aeremin/chibi-armlet/README.md

View this project on [CADLAB.io](https://cadlab.io/project/1101). 

Fallout Device project.

-- Moved from https://code.google.com/p/chibi-armlet
