aeremin/chibi-armlet/Hardware/Gerber/Berelcom/Бланк заказа печатных плат.xls

 | ООО “Берёзка Электронные Компоненты”
 | www.berelcom.ru e-mail: project@berelcom.ru тел./факс (495) 781-59-25
 | г. Москва, Колодезный переулок, д.3, стр.23, офис № 11
Бланк заказа печатных плат |  |  |  | Наличный |  | Необходим |  | Новый
Данные о заказчике |  |  |  | Безналичный |  | Не нужен |  | Повторный (без изменений)
Название фирмы или имя заказчика |  | ООО «ВВПАСС Корпорация»
ИНН |  | 7728668847
КПП |  | 770501001 |  | Зеленая | Мультипликации нет - каждая плата отдельно | Отсутствует |  | ОПП - односторонняя
Плательщик (если различно с заказчиком) |  |  |  | Бесцветная | Мультипликация есть - описано в дополнених | Жидкая |  | ДПП - двухсторонняя
Адрес (юридический), включая индекс |  | 115184, г. Москва, ул. Большая Татарская, д. 42 |  | Синяя |  | Жидкая Imagecure |  | МПП - многослойная
Телефон/факс с указанием кода города |  | +7 916 989 5800 |  | Желтая |  | Пленочная
e-mail |  | laystoll@yandex.ru |  | Чёрная |  | Сухая
Контактное лицо по заказу |  | Геннадий Круглов |  | Красная |  | Сухая DYNAMASK
Вид расчёта |  | Безналичный |  |  |  | Фотомаска жидкая
Параметры заказываемых плат |  |  |  |  |  | Фотоэкспонируемая термоотверждаемая
Название платы (должно совпадать с названием файла) |  | Chibiarmlet3
Новый или повторный (без изменений) заказ в ООО "Березка ЭК" |  | Новый |  |  |  |  | FR4 | Горячее лужение (HAL)
Система проектирования |  | GERBER |  | Не закрыты маской |  |  | FR2 | Бессвинцовое горячее лужение (HASL)
Количество слоев |  | ДПП - двухсторонняя | Количество слоев для МПП | Закрыты маской |  |  | FR1 | хим. Ni/Au
Количество, шт. |  | 700 |  |  |  |  | CEM-1 | гальв. Ni/Au
Длина платы, мм. (максимальное значение 1100 мм) |  | 114 |  | Скрайбирование |  |  | CEM-1 | Карбоновое покрытие (Carbon)
Ширина платы, мм. (максимальное значение 610 мм) |  | 16 |  | Фрезеровка
Толщина платы, мм. (стандартное значение 1,6 мм) |  | 1.5 |  | Вырубка |  | 0.8 | 5
Тип материала (стандартное значение: FR4) |  | FR4 |  |  |  | 1 | 9
Срок производства (стандартное значение: 4 недели) |  | 4 недели |  | 1 неделя |  | 1.2 | 17.5
Толщина медной фольги (стандартное значение: 35мкм) |  | 35 |  | 2 недели |  | 1.5 | 35
Наличие и тип маски (стандартное значение: жидкая) |  | Жидкая |  | 4 недели |  | 1.55 | 70
Цвет паяльной маски (стандартное значение: зеленая) |  | Зеленая |  |  |  | 1.6 | 105
Наличие шелкографии |  | Только на стороне TOP |  | Отсутствует |  | 2 | Иное - описано в дополнениях
Переходные отверстия (стандартное значение: не закрыты маской) |  | Не закрыты маской |  | С двух сторон |  | 2.4
Мехобработка контура |  | Фрезеровка |  | Только на стороне TOP |  | 3.2
Необходимость мультиплицирования плат на заготовке |  | Мультипликация есть - описано в дополнених |  | Только на стороне BOTTOM |  | Иное - описано в дополнениях
Электротест |  | Необходим
Покрытие контактных площадок (стандартное значение: HASL) |  | Бессвинцовое горячее лужение (HASL)
Дополнительные требования
Нужна сборка плат: трафарет, закупка и монтаж компонентов
При подготовке трафарета просьба связаться с нами: нужно не наносить пасту на контактные площадки немонтируемых компонентов
