aeremin/chibi-armlet/Hardware/Gerber/Berelcom/ChibiArmlet-BOM.xlsx

Document version | ChibiArmlet-BOM v.20131229.1300
Reference | Footprint | Value | Item count | Price | URL | Комментарий
Микросхемы
DD1 | LQFP-48 | STM32L151CBT | 1 | $2.62 | http://www.compel.ru/infosheet/ST/STM32L151CBT6/
DD2 | QFN20 | CC1101 | 1 | $1.86 | http://www.compel.ru/infosheet/TI/CC1101RTKR/
DA1 | SOT23-5 | NCP1400ASN33 | 1 | $0.4044 | http://www.compel.ru/infosheet/ONS/NCP1400ASN33T1G/ | Источник питания
Активные компоненты
Q1, Q2 | SOT23 | MMBT2222 | 2 | $0.0101 | http://www.compel.ru/infosheet/NXP/MMBT2222A.215/
Q3 | LED5050 | LED_RGB | 1 | 1.86р | http://www.zip-2002.ru/?z=grey&i=119&p=651&id=96169/
D1, D2 | SOD-323 | BAT54WS | 2 | $0.023 | http://www.berelcom.ru/shop/show_good.php?idtov=2130747219&grid= | Диод Шоттки
Пассивные компоненты
XTAL1 | SMD3225 | 27MHz | 1 | 7.65р | http://www.quartz1.com/price/model.php?akt=6935.12 | Резонатор на 27МГц 10ppm в SMD корпусе размером 3.2х2.5мм
BZ1 | DIP2 | HC0903A | 1 | 7.5р | http://www.quartz1.com/price/model.php?akt=8420.12 | Пищалка
Конденсаторы
C1, C12, C17, C22, C24 | CAP_0603 | 10u 6.3V | 5 | $0.084 | http://www.compel.ru/infosheet/MUR/GRM188R60J106ME47D/ | Конденсатор в корпусе 0603, точность 20%, напряжение не менее 6.3В
C2 | CAP_0402 | 1.8pF | 1 | $0.045 | http://www.digikey.com/product-detail/en/500R07S1R8BV4T/712-1271-1-ND/1786733 | Конденсатор JOHANSON p/n 500R07S1R8BV4T
C3, C8 | CAP_0402 | 220pF | 2 |  |  | Конденсатор в корпусе 0402, диэлектрик NPO, точность 5%
C4, C6, C15 | CAP_0402 | 10n | 3 |  |  | Конденсатор в корпусе 0402, точность 20%
C5 | CAP_0402 | 3.3pF | 1 |  |  | Конденсатор в корпусе 0402, диэлектрик NPO, точность 5%
C7, C11, C13, C14, C18, C21, C23 | CAP_0402 | 0.1u | 7 |  |  | Конденсатор в корпусе 0402, точность 20%
C9, C10 | CAP_0402 | 10pF | 2 |  |  | Конденсатор в корпусе 0402, диэлектрик NPO, точность 5%
С16 | CAP_0402 | 1u | 1 |  |  | Конденсатор в корпусе 0402, точность 20%
Резисторы
R1, R4, R12 | RES_0402 | 1k | 3 |  |  | Резистор в корпусе 0402, точность не хуже 5%
R2 | RES_0402 | 56k | 1 |  |  | Резистор в корпусе 0402, точность не хуже 1%
R5, R6 | RES_0402 | 4k7 | 2 |  |  | Резистор в корпусе 0402, точность не хуже 5%
R7 | RES_0402 | 150R | 1 |  |  | Резистор в корпусе 0402, точность не хуже 5%
R8, R9, R10 | RES_0402 | 51R | 3 |  |  | Резистор в корпусе 0402, точность не хуже 5%
Индуктивности
L1 | IND_0402 | 5.6nH | 1 | $0.02926 | http://www.digikey.com/product-detail/en/L-07C5N6SV6T/712-1462-1-ND/1915241 | Катушка JOHANSON p/n L-07C5N6SV6T
L2 | IND_1210 | 22uH | 1 | $0.14576 | http://www.digikey.com/product-detail/en/CBC3225T220MR/587-1626-1-ND/1008241 | Индуктивность 22uH +- 20%, ток рабочий и насыщения не менее 500мА, сопротивление не более 0.5Ом
BLN1 | BLN_0805 | 0896BM15A0001E | 1 | $0.5225 | http://www.compel.ru/infosheet/JOHANSON/0896BM15A0001E/
Разъемы
XL1, XL2, XL3 |  | Do not mount | 0
XL4 | DIP4 | PBS-1x04R | 1 | 1.29р | http://www.zip-2002.ru/?z=grey&i=97&p=332&id=58364/ | Разъем 1х4 угловой, шаг 2.54мм
B3 | Держатель 1хAA | BH311 | 1 | 4.11р | http://www.zip-2002.ru/?z=grey&i=109&p=401&id=59649/ | Держатель одной батарейки АА с монтажом на плату.
M1 |  | Do not mount | 0
