aeremin/chibi-armlet/Hardware/Gerber/Berelcom/BOM_Request.xlsx

Название | Тип | Корпус | Ссылка | Цена по ссылке | Требуемые характеристики
Контроллер | STM32F030C8T6 | LQFP-48 | http://riv-e.ru/price/STM32F030C8T6 | 35.1р
Контроллер | STM32F051C8T6 | LQFP-48 | http://www.compel.ru/infosheet/ST/STM32F051C8T6/ | $1.5
Контроллер | STM32L151C8T6 | LQFP-48 | http://www.compel.ru/infosheet/ST/STM32L151C8T6/ | $2.69
Контроллер | STM32L151CBT6 | LQFP-48 | http://www.compel.ru/infosheet/ST/STM32L151CBT6/ | $2.62
Радиотрансивер |  | QFN-20 | http://www.compel.ru/infosheet/TI/CC1101RTKR/ | $1.86
Источник питания | NCP1400ASN33 | SOT23-5 | http://www.compel.ru/infosheet/ONS/NCP1400ASN33T1G/ | $0.4044
Диод Шоттки | MBR0520LT1G | SOD-123 | http://www.compel.ru/infosheet/ONS/MBR0520LT1G/ | $0.0592
Транзистор NPN | MMBT2222 | SOT23 | http://www.compel.ru/infosheet/NXP/MMBT2222A.215/ | $0.0101
RGB светодиод |  | SMD 5050 | http://www.zip-2002.ru/?z=grey&i=119&p=651&id=96169/ | 1.86р
Кварц. резонатор |  | SMD 3225 | http://www.quartz1.com/price/model.php?akt=6935.12 | 7.65р | Резонатор на 27МГц 10ppm в SMD корпусе размером 3.2х2.5мм или меньше.
BALUN | 0896BM15A0001E | 0805 | http://www.compel.ru/infosheet/JOHANSON/0896BM15A0001E/ | $0.5225
Пищалка | HC0903A |  | http://www.quartz1.com/price/model.php?akt=8420.12 | 7.5р
Конденсаторы
1.8pF | 500R07S1R8BV4T | 0402 | http://www.digikey.com/product-detail/en/500R07S1R8BV4T/712-1271-1-ND/1786733 | $0.045 | Конденсатор JOHANSON p/n 500R07S1R8BV4T
3.3pF |  | 0402 |  |  | Конденсатор в корпусе 0402, диэлектрик NPO, точность 5%
10pF |  | 0402 |  |  | Конденсатор в корпусе 0402, диэлектрик NPO, точность 5%
100pF |  | 0402 |  |  | Конденсатор в корпусе 0402, диэлектрик NPO, точность 5%
220pF |  | 0402 |  |  | Конденсатор в корпусе 0402, диэлектрик NPO, точность 5%
10n |  | 0402 |  |  | Конденсатор в корпусе 0402, точность 20%
0.1u |  | 0402 |  |  | Конденсатор в корпусе 0402, точность 20%
1u |  | 0402 |  |  | Конденсатор в корпусе 0402, точность 20%
10u |  | 0603 | http://www.compel.ru/infosheet/MUR/GRM188R60J106ME47D/ | $0.084 | Конденсатор в корпусе 0603, точность 20%, напряжение не менее 6.3В
Резисторы
51R |  | 0402 |  |  | Резистор в корпусе 0402, точность не хуже 5%
150R |  | 0402 |  |  | Резистор в корпусе 0402, точность не хуже 5%
1k |  | 0402 |  |  | Резистор в корпусе 0402, точность не хуже 5%
4k7 |  | 0402 |  |  | Резистор в корпусе 0402, точность не хуже 5%
56k |  | 0402 |  |  | Резистор в корпусе 0402, точность не хуже 1%
Индуктивности
5.6nH | L-07C5N6SV6T | 0402 | http://www.digikey.com/product-detail/en/L-07C5N6SV6T/712-1462-1-ND/1915241 | $0.02926 | Катушка JOHANSON p/n L-07C5N6SV6T
22uH | CBC3225T220MR | 1210 | http://www.digikey.com/product-detail/en/CBC3225T220MR/587-1626-1-ND/1008241 | $0.14576 | Индуктивность 22uH +- 20%, ток рабочий и насыщения не менее 500мА, сопротивление не более 0.5Ом, размер не более 1210.
Разъемы и прочее
PBS | PBS2-04R |  | http://www.zip-2002.ru/?z=grey&i=97&p=441&id=63418/ | 2.53р
Держатель 1хAA | BH311 |  | http://www.zip-2002.ru/?z=grey&i=109&p=401&id=59649/ | 4.11р | Держатель одной батарейки АА с монтажом на плату.
