aeremin/chibi-armlet/Hardware/Gerber/Rezonit/ChibiArmlet-BOM.xlsx

Document version | ChibiArmlet-BOM v.20131105.2258
Reference | Footprint | Value | Item count | Description | Solder Point per cmp | SolderPoint total
Микросхемы
DD1 | UFQFPN48 | STM32L100C6 | 1 | Предоставим в трее | 49 | 49
DD2 | QFN20 | CC1101 | 1 | Предоставим в трее | 20 | 20
DA1 | SOT23-5 | NCP1400ASN33 | 1 | Предоставим в ленте | 5 | 5
Активные компоненты
Q1 | SOT23 | MMBT2222 | 1 | Предоставим в ленте | 3 | 3
Q3 | LED5050 | LED_RGB | 1 | Предоставим в ленте | 6 | 6
D1 | SOD-323 | BAT54WS | 1 | Предоставим в ленте | 2 | 2
Пассивные компоненты
XTAL1 | SMD3225 | 27MHz | 1 | Предоставим в ленте | 4 | 4
BZ1 | DIP2 | Do not mount
Конденсаторы
C1 | CAP_0402 | 100pF NPO | 1 | Предоставим в ленте | 2 | 2
C2 | CAP_0402 | 1.8pF NPO | 1 | Предоставим в ленте | 2 | 2
C3, C8 | CAP_0402 | 220pF NPO | 2 | Предоставим в ленте | 2 | 4
C4, C6, C15 | CAP_0402 | 10nF | 3 | Предоставим в ленте | 2 | 6
C5 | CAP_0402 | 3.3pF NPO | 1 | Предоставим в ленте | 2 | 2
C7, C11, C13, C14, C21, C23 | CAP_0402 | 0.1u | 6 | Предоставим в ленте | 2 | 12
C9, C10 | CAP_0402 | 10pF | 2 | Предоставим в ленте | 2 | 4
C12, C22, C24 | CAP_0805 | 10uF | 3 | Предоставим в ленте | 2 | 6
С16 | CAP_0402 | 1uF | 1 | Предоставим в ленте | 2 | 2
Резисторы
R1, R4 | RES_0402 | 1k | 2 | Предоставим в ленте | 2 | 4
R2 | RES_0402 | 56k | 1 | Предоставим в ленте | 2 | 2
R3 | RES_0402 | Do not mount
R5, R6 | RES_0402 | 4k7 | 2 | Предоставим в ленте | 2 | 4
R7 | RES_0603 | 150R | 1 | Предоставим в ленте | 2 | 2
R8, R9, R10 | RES_0402 | 51R | 3 | Предоставим в ленте | 2 | 6
Индуктивности
L1 | IND_0402 | 5.6nH | 1 | Предоставим в ленте | 2 | 2
L2 | IND_1210 | 22uH | 1 | Предоставим в ленте | 2 | 2
BLN1 | BLN_0805 | 0896BM15A0001E | 1 | Предоставим в ленте | 6 | 6
Разъемы
XL1, XL2, XL3 |  | Do not mount
XL4 | DIP4@2mm | Do not mount
BH3 | DIP2 | Do not mount |  |  | Solder points per brd | 88
