aeremin/chibi-armlet/ChangeLog.docx

V1 – V2

- Корпус проца LQFP вместо QFN.
- Диод в корпусе SOD123 вместо SOD323
- Конденсаторы 10мкФ в корпусе 0603 вместо 0805
- Резистор 150 Ом в корпусе 0402 вместо 0603
- Две REFPOINTS, а не четыре
- Добавить Debug conn
- Добавить вибромотор
