aeremin/chibi-armlet/Hardware/ChibiArmletPcb.pdf

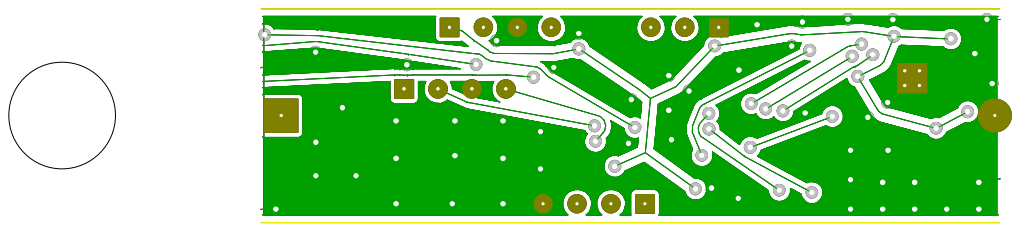
[picture p1: page 1]
