aeremin/chibi-armlet/Pill/Pill4.kicad_pcb

## KiCad design Pill/Pill4.kicad_pcb (2014-04-10)

Schematic: Pill4.sch

Parts:
C1: 0.1u; CAP_0603
DD1: M24C04; SO8E
F1, F2, F3: FUSE0R
XL1: CONN_4

Connections:
+3.3V: C1.1, DD1.8 (Vcc), F1.2, F2.2, F3.2, XL1.1
/1: DD1.1 (A0), F1.1
/2: DD1.2 (A1), F2.1
/3: DD1.3 (A2), F3.1
/I2C_SCL: DD1.6 (SCL), XL1.2 (PM)
/I2C_SDA: DD1.5 (SDA), XL1.4
GND: C1.2, DD1.4 (GND), DD1.7 (WP), XL1.3

Notes on the sheet:
I2C Addr = 1010 (A2)(A1)(A0) in case of 1 or 2 kBit, I2C Addr = 1010 (A2)(A1) in case of 4 kBit. A2, A1, A0 are read as 0 when left floating

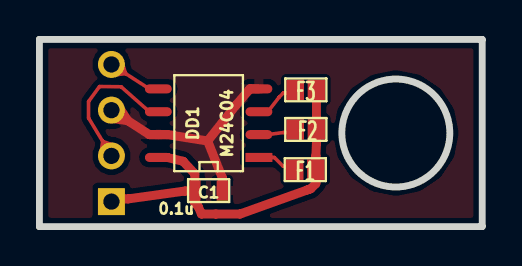
[picture p2: board Pill4.kicad_pcb from above]

Board: 2 copper layers, 24.6 x 10.4 mm, 6 parts (1 on the bottom side), 7 nets.
