aeremin/chibi-armlet/Hardware/ChibiArmlet.kicad_pcb

## KiCad design Hardware/ChibiArmlet.kicad_pcb (2013-12-29)

Schematic: ChibiArmlet.sch

Parts:
ANT1: ANT_PCB_MONO
B3: BAT
BLN1: 0896BM15A0001
BZ1: BUZZER
C1, C12, C17: 10u; CAP_0603
C2: 1.8pF
C3, C8: 220pF
C4, C6: 10n
C5: 3.3pF
C7, C11, C21, C23: 0.1u
C9, C10: 10pF; CAP_0402
C13, C14, C18: 0.1u; CAP_0402
C15: 10n; CAP_0402
C16: 1u; CAP_0402
C22, C24: 10u
D1, D2: BAT54WS
DA1: NCP1400
DD1: STM32L151CXTX
DD2: CC1101
L1: 5.6nH; IND_0402
L2: 22uH
M1: MOTOR_PAD
Q1, Q2: MMBT2222
Q3: LED_RGB 5050
R1: 1k; RES_0402
R2: 56k
R4, R12: 1k
R5, R6: 4K7; RES_0402
R7: 150; RES_0402
R8, R9, R10: 51R; RES_0603
RP1, RP2: REFPOINT
TP1, TP2: TESTPOINT
XL1: ST_SWD
XL2: CONN_3
XL3: CONN_4
XL4: CONN_4
XTAL1: 27MHz; 03225

Connections:
+3.3V: BZ1.1, C3.1, C4.1, C5.1, C6.1, C7.1, C8.1, C12.1, C13.1, C14.1, C15.1, C16.1, C17.1, C18.1, C23.1, C24.1, D2.C, DA1.1 (CE), DA1.2 (OUT), DD1.1, DD1.9, DD1.24, DD1.36, DD1.48, DD2.4 (DVDD), DD2.9 (AVDD), DD2.11 (AVDD), DD2.14 (AVDD), DD2.15 (AVDD), DD2.18 (DGUARD), XL1.1 (Vdd)
+BATT: B3.A, C1.1, C21.1, C22.1, D1.C, L2.2, M1.2 (-), R1.2
/BLUE_LED: DD1.18, R10.1
/Buzzer: DD1.39, R4.1
/BuzzerOut: BZ1.2, Q2.3 (C)
/CC_CS: DD1.14, DD2.7 (CSn)
/CC_GDO0: DD1.13, DD2.6 (GDO0), TP1.1
/CC_GDO2: DD1.12, DD2.3 (GDO2), TP2.1
/CC_MISO: DD1.16, DD2.2 (SO(GDO1))
/CC_MOSI: DD1.17, DD2.20 (SI)
/CC_SCK: DD1.15, DD2.1 (SCLK)
/GREEN_LED: DD1.41, R9.1
/Lout: D2.A, DA1.5 (LX), L2.1
/P_SCL: DD1.45, R5.1, XL4.2 (PM)
/P_SDA: DD1.46, R6.1, XL4.4
/PeriphPwr: DD1.43, R5.2, R6.2, R7.2
/PeriphPwr1: R7.1, XL4.1
/RED_LED: DD1.19, R8.1
/RF1: BLN1.4 (Bal2), DD2.12 (RF_P)
/RF2: BLN1.3 (Bal1), DD2.13 (RF_N)
/SWCLK: DD1.37, XL1.2 (SWCLK)
/SWDIO: DD1.34, XL1.4 (SWDIO)
/UART_RX: DD1.31, XL2.3
/UART_TX: DD1.30, XL2.2 (PM)
/Vibro: DD1.42, R12.1
/VibroOut: D1.A, M1.1 (+), Q1.3 (C)
GND: B3.C, BLN1.2 (GND), BLN1.5 (GND), BLN1.6 (GND), C1.2, C2.2, C3.2, C4.2, C5.2, C6.2, C7.2, C8.2, C9.2, C10.2, C11.2, C12.2, C13.2, C14.2, C15.2, C16.2, C17.2, C18.2, C21.2, C22.2, C23.2, C24.2, DA1.4 (GND), DD1.8, DD1.23, DD1.35, DD1.44, DD1.47, DD2.16 (GND), DD2.19 (GND), DD2.PAD (GND), M1.PAD (GND), Q1.2 (E), Q2.2 (E), Q3.BC (B), Q3.GC (G), Q3.RC, R2.2, XL1.3 (GND), XL2.1, XL3.4, XL4.3, XTAL1.H
unnamed: BLN1.1 (Unbal), L1.2
unnamed: Q3.BA, R10.2
unnamed: Q3.RA, R8.2
unnamed: Q3.GA, R9.2
unnamed: Q2.1 (B), R4.2
unnamed: C11.1, DD2.5 (DCOUPL)
unnamed: C10.1, DD2.10 (XOSC_Q2), XTAL1.2
unnamed: C9.1, DD2.8 (XOSC_Q1), XTAL1.1
unnamed: DD2.17 (RBIAS), R2.1
unnamed: DD1.10, R1.1
unnamed: ANT1.1, C2.1, L1.1
unnamed: Q1.1 (B), R12.2
unnamed: DD1.4, XL3.1
unnamed: DD1.3, XL3.2 (PM)
unnamed: DD1.2, XL3.3

Notes on the sheet:
Debug port
Programming
CPU
Indication
Power
Radio
Matching circuit
L-07C5N6SV4
500R07S1R8BV4
Peripheral I2C Pull-Ups
Pill Connector
Pill
1xAA
Just Pins

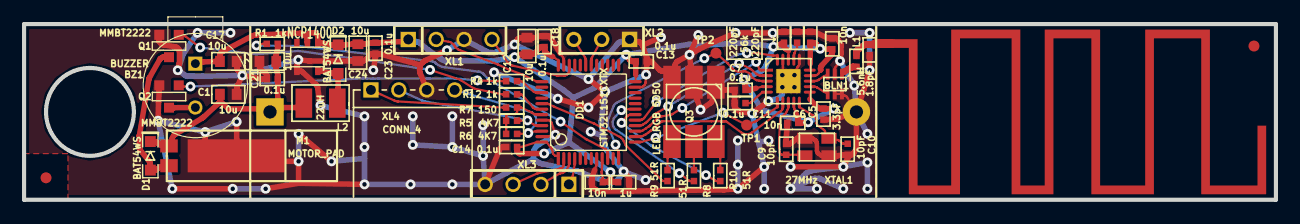
[picture p3: board ChibiArmlet.kicad_pcb from above]

Board: 2 copper layers, 114.0 x 16.0 mm, 56 parts (0 on the bottom side), 42 nets.
