aeremin/chibi-armlet/Firmware/Basic/src/main.cpp

/*
 * File:   main.cpp
 * Author: Kreyl
 * Project: Armlet2South
 *
 * Created on Feb 05, 2013, 20:27
 */

#include <main.h>
#include "kl_lib.h"
#include "ch.h"
#include "hal.h"
#include "clocking_L1xx.h"
#include "uart.h"
#include "radio_lvl1.h"
#include "evt_mask.h"
#include "vibro.h"
#include "Sequences.h"

Vibro_t Vibro(GPIOB, 6, TIM4, 1);
App_t App;

#if 1 // ============================ Timers ===================================
void TmrSecondCallback(void *p) {
    chSysLockFromIsr();
    App.SignalEvtI(EVTMSK_EVERY_SECOND);
    chVTSetI(&App.TmrSecond, MS2ST(1000), TmrSecondCallback, nullptr);
    chSysUnlockFromIsr();
}
#endif

int main(void) {
    // ==== Init Vcore & clock system ====
    SetupVCore(vcore1V2);
    Clk.UpdateFreqValues();
    // ==== Init OS ====
    halInit();
    chSysInit();
    // ==== Init Hard & Soft ====
    App.InitThread();
    chVTSet(&App.TmrSecond, MS2ST(1000), TmrSecondCallback, nullptr);
    Uart.Init(115200);
    Uart.Printf("\r%S  AHB freq=%u", VERSION_STRING, Clk.AHBFreqHz);
//    Led.Init();

//    Radio.Init();

    Vibro.Init();


    // Main cycle
    App.ITask();
}


__attribute__ ((__noreturn__))
void App_t::ITask() {
    while(true) {
        Vibro.StartSequence(vsqBrrBrr);
        chThdSleepMilliseconds(1800);
//        chThdSleepMilliseconds(999);
//        uint32_t EvtMsk = chEvtWaitAny(ALL_EVENTS);
        // ==== Uart cmd ====
//        if(EvtMsk & EVTMSK_UART_NEW_CMD) {
//            OnUartCmd(&Uart);
//            Uart.SignalCmdProcessed();
//        }

        // ==== Every second ====
//        if(EvtMsk & EVTMSK_EVERY_SECOND) {
            // Get mode
//            uint8_t b = GetDipSwitch();
//            b &= 0b00000111;    // Consider only lower bits
//            Mode_t NewMode = static_cast<Mode_t>(b);
//            if(Mode != NewMode) {
//                if(Mode == mError) Led.StartSequence(lsqFailure);
//                else {
//                    Led.StartSequence(lsqStart);
//                    Mode = NewMode;
//                }
//                chThdSleepMilliseconds(540);
//            }
//        }

#if 0 // ==== Radio ====
        if(EvtMsk & EVTMSK_RADIO_RX) {
            Uart.Printf("\rRadioRx");
            chVTRestart(&ITmrRadioTimeout, S2ST(RADIO_NOPKT_TIMEOUT_S), EVTMSK_RADIO_ON_TIMEOUT);
            if(Mode == mRxLight or Mode == mRxVibroLight)
        }
        if(EvtMsk & EVTMSK_RADIO_ON_TIMEOUT) {
//            Uart.Printf("\rRadioTimeout");
            RadioIsOn = false;
            Interface.ShowRadio();
            IProcessLedLogic();
        }
#endif

#if 0 // ==== Saving settings ====
        if(EvtMsk & EVTMSK_SAVE) { ISaveSettingsReally(); }
#endif

    } // while true
}

void App_t::OnUartCmd(Uart_t *PUart) {
    UartCmd_t *PCmd = &PUart->Cmd;
    __attribute__((unused)) int32_t dw32 = 0;  // May be unused in some configurations
    Uart.Printf("\r%S\r", PCmd->Name);
    // Handle command
    if(PCmd->NameIs("Ping")) PUart->Ack(OK);

//    else if(PCmd->NameIs("GetID")) Uart.Reply("ID", ID);

//    else if(PCmd->NameIs("SetID")) {
//        if(PCmd->GetNextToken() != OK) { PUart->Ack(CMD_ERROR); return; }
//        if(PCmd->TryConvertTokenToNumber(&dw32) != OK) { PUart->Ack(CMD_ERROR); return; }
//        uint8_t r = ISetID(dw32);
//        PUart->Ack(r);
//    }

    else PUart->Ack(CMD_UNKNOWN);
}
