aeremin/chibi-armlet/Firmware/Common/kl_lib/kl_lib_L15x.h

/*
 * kl_lib_f0xx.h
 *
 *  Created on: 10.12.2012
 *      Author: kreyl
 */

#ifndef KL_LIB_F100_H_
#define KL_LIB_F100_H_

#include "stm32l1xx.h"
#include "ch.h"
#include "hal.h"
#include "clocking_L1xx.h"
#include "core_cmInstr.h"
#include <cstdlib>

#if 1 // ============================ General ==================================
#define PACKED __attribute__ ((__packed__))
#ifndef countof
#define countof(A)  (sizeof(A)/sizeof(A[0]))
#endif

// Constants
#ifndef TRUE
#define TRUE 1
#endif
#ifndef FALSE
#define FALSE 0
#endif
#define MAX_INT32       0x7FFFFFFF
#define MIN_INT32       (-2147483647)
#define MAX_UINT32      0xFFFFFFFF

// Return values
#define OK              0
#define FAILURE         1
#define TIMEOUT         2
#define BUSY            3
#define NEW             4
#define IN_PROGRESS     5
#define LAST            6
#define CMD_ERROR       7
#define WRITE_PROTECT   8
#define CMD_UNKNOWN     9
#define EMPTY_STRING    10
#define NOT_A_NUMBER    11

// Binary semaphores
#define NOT_TAKEN       false
#define TAKEN           true

enum BitOrder_t {boMSB, boLSB};
enum LowHigh_t  {Low, High};
enum RiseFall_t {Rising, Falling};

typedef void (*ftVoidVoid)(void);

// Simple pseudofunctions
// Simple pseudofunctions
#define MIN(a, b)   ( ((a)<(b))? (a) : (b) )
#define MAX(a, b)   ( ((a)>(b))? (a) : (b) )
#define TRIM_VALUE(v, Max)  { if((v) > (Max)) (v) = (Max); }
#define IS_LIKE(v, precise, deviation)  (((precise - deviation) < v) and (v < (precise + deviation)))

#define ANY_OF_2(a, b1, b2)             (((a)==(b1)) or ((a)==(b2)))
#define ANY_OF_3(a, b1, b2, b3)         (((a)==(b1)) or ((a)==(b2)) or ((a)==(b3)))
#define ANY_OF_4(a, b1, b2, b3, b4)     (((a)==(b1)) or ((a)==(b2)) or ((a)==(b3)) or ((a)==(b4)))
#define ANY_OF_5(a, b1, b2, b3, b4, b5) (((a)==(b1)) or ((a)==(b2)) or ((a)==(b3)) or ((a)==(b4)) or ((a)==(b5)))

// IRQ priorities
#define IRQ_PRIO_LOW            15  // Minimum
#define IRQ_PRIO_MEDIUM         9
#define IRQ_PRIO_HIGH           7
#define IRQ_PRIO_VERYHIGH       4   // Higher than systick

// DMA
#define DMA_PRIORITY_LOW        STM32_DMA_CR_PL(0b00)
#define DMA_PRIORITY_MEDIUM     STM32_DMA_CR_PL(0b01)
#define DMA_PRIORITY_HIGH       STM32_DMA_CR_PL(0b10)
#define DMA_PRIORITY_VERYHIGH   STM32_DMA_CR_PL(0b11)

// Different conversions
class Convert {
public:
    static void U16ToArrAsBE(uint8_t *PArr, uint16_t N) {
        uint8_t *p8 = (uint8_t*)&N;
        *PArr++ = *(p8 + 1);
        *PArr   = *p8;
    }
    static void U32ToArrAsBE(uint8_t *PArr, uint32_t N) {
        uint8_t *p8 = (uint8_t*)&N;
        *PArr++ = *(p8 + 3);
        *PArr++ = *(p8 + 2);
        *PArr++ = *(p8 + 1);
        *PArr   = *p8;
    }
    static uint16_t ArrToU16AsBE(uint8_t *PArr) {
        uint16_t N;
        uint8_t *p8 = (uint8_t*)&N;
        *p8++ = *(PArr + 1);
        *p8 = *PArr;
        return N;
    }
    static uint32_t ArrToU32AsBE(uint8_t *PArr) {
        uint32_t N;
        uint8_t *p8 = (uint8_t*)&N;
        *p8++ = *(PArr + 3);
        *p8++ = *(PArr + 2);
        *p8++ = *(PArr + 1);
        *p8 = *PArr;
        return N;
    }
    static void U16ChangeEndianness(uint16_t *p) { *p = __REV16(*p); }
    static void U32ChangeEndianness(uint32_t *p) { *p = __REV(*p); }
    static inline uint8_t TryStrToUInt32(char* S, uint32_t *POutput) {
        if(*S == '\0') return EMPTY_STRING;
        char *p;
        *POutput = strtoul(S, &p, 0);
        return (*p == 0)? OK : NOT_A_NUMBER;
    }
    static inline uint8_t TryStrToInt32(char* S, int32_t *POutput) {
        if(*S == '\0') return EMPTY_STRING;
        char *p;
        *POutput = strtol(S, &p, 0);
        return (*p == '\0')? OK : NOT_A_NUMBER;
    }
};


// Init, to calm compiler
extern "C" {
void __attribute__ ((weak)) _init(void)  {}
}
#endif

#if 1 // =========================== Time ======================================
static inline bool TimeElapsed(systime_t *PSince, uint32_t Delay_ms) {
    chSysLock();
    bool Rslt = (systime_t)(chTimeNow() - *PSince) > MS2ST(Delay_ms);
    if(Rslt) *PSince = chTimeNow();
    chSysUnlock();
    return Rslt;
}
#endif

#if 0 // ========================== Simple delay ===============================
static inline void DelayLoop(volatile uint32_t ACounter) { while(ACounter--); }
static inline void Delay_ms(uint32_t Ams) {
    volatile uint32_t __ticks = (Clk.AHBFreqHz / 4000) * Ams;
    DelayLoop(__ticks);
}
#endif

#if 1 // ===================== Single pin manipulations ========================
enum PinOutMode_t {
    omPushPull  = 0,
    omOpenDrain = 1
};
enum PinPullUpDown_t {
    pudNone = 0b00,
    pudPullUp = 0b01,
    pudPullDown = 0b10
};
enum PinSpeed_t {
    ps400kHz = 0b00,
    ps2MHz   = 0b01,
    ps10MHz  = 0b10,
    ps40MHz  = 0b11
};
enum PinAF_t {
    AF0=0, AF1=1, AF2=2, AF3=3, AF4=4, AF5=5, AF6=6, AF7=7,
    AF8=8, AF9=9,AF10=10, AF11=11, AF12=12, AF13=13, AF14=14, AF15=15
};

// Set/clear
static inline void PinSet    (GPIO_TypeDef *PGpioPort, const uint16_t APinNumber) { PGpioPort->BSRRL = (uint16_t)(1<<APinNumber); }
static inline void PinClear  (GPIO_TypeDef *PGpioPort, const uint16_t APinNumber) { PGpioPort->BSRRH = (uint16_t)(1<<APinNumber); }
static inline void PinToggle (GPIO_TypeDef *PGpioPort, const uint16_t APinNumber) { PGpioPort->ODR  ^= (uint16_t)(1<<APinNumber); }
// Check state
static inline bool PinIsSet(GPIO_TypeDef *PGpioPort, const uint16_t APinNumber) { return (PGpioPort->IDR & (uint32_t)(1<<APinNumber)); }
// Setup
static inline void PinClockEnable(GPIO_TypeDef *PGpioPort) {
    if     (PGpioPort == GPIOA) RCC->AHBENR |= RCC_AHBENR_GPIOAEN;
    else if(PGpioPort == GPIOB) RCC->AHBENR |= RCC_AHBENR_GPIOBEN;
    else if(PGpioPort == GPIOC) RCC->AHBENR |= RCC_AHBENR_GPIOCEN;
    else if(PGpioPort == GPIOD) RCC->AHBENR |= RCC_AHBENR_GPIODEN;
}
static inline void PinSetupOut(
        GPIO_TypeDef *PGpioPort,
        const uint16_t APinNumber,
        const PinOutMode_t PinOutMode,
        const PinPullUpDown_t APullUpDown = pudNone,
        const PinSpeed_t ASpeed = ps40MHz
        ) {
    // Clock
    PinClockEnable(PGpioPort);
    uint8_t Offset = APinNumber*2;
    // Setup mode
    PGpioPort->MODER &= ~(0b11 << Offset);  // clear previous bits
    PGpioPort->MODER |=   0b01 << Offset;   // Set new bits
    // Setup output type
    PGpioPort->OTYPER &= ~(1<<APinNumber);
    PGpioPort->OTYPER |= (uint32_t)PinOutMode << APinNumber;
    // Setup Pull-Up or Pull-Down
    PGpioPort->PUPDR &= ~(0b11 << Offset); // clear previous bits
    PGpioPort->PUPDR |= (uint32_t)APullUpDown << Offset;
    // Setup speed
    PGpioPort->OSPEEDR &= ~(0b11 << Offset); // clear previous bits
    PGpioPort->OSPEEDR |= (uint32_t)ASpeed << Offset;

}
static inline void PinSetupIn(
        GPIO_TypeDef *PGpioPort,
        const uint16_t APinNumber,
        const PinPullUpDown_t APullUpDown
        ) {
    // Clock
    PinClockEnable(PGpioPort);
    // Setup mode
    PGpioPort->MODER &= ~(0b11 << (APinNumber*2)); // clear previous bits
    // Setup Pull-Up or Pull-Down
    PGpioPort->PUPDR &= ~(0b11 << (APinNumber*2)); // clear previous bits
    PGpioPort->PUPDR |= (uint32_t)APullUpDown << (APinNumber*2);
}
static inline void PinSetupAnalog(GPIO_TypeDef *PGpioPort, const uint16_t APinNumber) {
    // Clock
    PinClockEnable(PGpioPort);
    // Setup mode
    PGpioPort->MODER |= 0b11 << (APinNumber*2);  // Set new bits
    // Disable pull-up/down
    PGpioPort->PUPDR &= ~(0b11 << (APinNumber*2)); // clear previous bits
}

static inline void PinSetupAlterFunc(
        GPIO_TypeDef *PGpioPort,
        const uint16_t APinNumber,
        const PinOutMode_t PinOutMode,
        const PinPullUpDown_t APullUpDown,
        const PinAF_t AAlterFunc,
        const PinSpeed_t ASpeed = ps10MHz) {
    // Clock
    PinClockEnable(PGpioPort);
    uint32_t Offset = APinNumber*2;
    // Setup mode
    PGpioPort->MODER &= ~(0b11 << Offset);  // clear previous bits
    PGpioPort->MODER |= 0b10 << Offset;     // Set new bits
    // Setup output type
    PGpioPort->OTYPER &= ~(1<<APinNumber);
    PGpioPort->OTYPER |= (uint32_t)PinOutMode << APinNumber;
    // Setup Pull-Up or Pull-Down
    PGpioPort->PUPDR &= ~(0b11 << Offset); // clear previous bits
    PGpioPort->PUPDR |= (uint32_t)APullUpDown << Offset;
    // Setup speed
    PGpioPort->OSPEEDR &= ~(0b11 << Offset); // clear previous bits
    PGpioPort->OSPEEDR |= (uint32_t)ASpeed << Offset;
    // Setup Alternate Function
    uint32_t n = (APinNumber <= 7)? 0 : 1;      // 0 if 0...7, 1 if 8..15
    Offset = 4 * ((APinNumber <= 7)? APinNumber : APinNumber - 8);
    PGpioPort->AFR[n] &= ~(0b1111 << Offset);
    PGpioPort->AFR[n] |= (uint32_t)AAlterFunc << Offset;
}

class PwmPin_t {
private:
    uint32_t *PClk;
    TIM_TypeDef* Tim;
public:
    __IO uint32_t *PCCR;    // Made public to allow DMA
    void SetFreqHz(uint32_t FreqHz);
    void Init(GPIO_TypeDef *GPIO, uint16_t N, TIM_TypeDef* PTim, uint8_t Chnl, uint16_t TopValue, bool Inverted=false);
    void Set(uint16_t Value) { *PCCR = Value; }
    void Off() { *PCCR = 0; }
};

#if 1 // ==== External IRQ ====
enum ExtiTrigType_t {ttRising, ttFalling, ttRisingFalling};

class PinIrq_t {
private:
    uint32_t IIrqChnl;
    GPIO_TypeDef *IGPIO;
    uint8_t IPinNumber;
public:
    void SetTriggerType(ExtiTrigType_t ATriggerType) {
        uint32_t IrqMsk = 1 << IPinNumber;
        switch(ATriggerType) {
            case ttRising:
                EXTI->RTSR |=  IrqMsk;  // Rising trigger enabled
                EXTI->FTSR &= ~IrqMsk;  // Falling trigger disabled
                break;
            case ttFalling:
                EXTI->RTSR &= ~IrqMsk;  // Rising trigger disabled
                EXTI->FTSR |=  IrqMsk;  // Falling trigger enabled
                break;
            case ttRisingFalling:
                EXTI->RTSR |=  IrqMsk;  // Rising trigger enabled
                EXTI->FTSR |=  IrqMsk;  // Falling trigger enabled
                break;
        } // switch
    }

    void Setup(GPIO_TypeDef *GPIO, const uint8_t APinNumber, ExtiTrigType_t ATriggerType) {
        IGPIO = GPIO;
        IPinNumber = APinNumber;
        rccEnableAPB2(RCC_APB2ENR_SYSCFGEN, FALSE); // Enable sys cfg controller
        // Connect EXTI line to the pin of the port
        uint8_t Indx   = APinNumber / 4;            // Indx of EXTICR register
        uint8_t Offset = (APinNumber & 0x03) * 4;   // Offset in EXTICR register
        SYSCFG->EXTICR[Indx] &= ~((uint32_t)0b1111 << Offset);  // Clear port-related bits
        // GPIOA requires all zeroes => nothing to do in this case
        if     (GPIO == GPIOB) SYSCFG->EXTICR[Indx] |= (uint32_t)0b0001 << Offset;
        else if(GPIO == GPIOC) SYSCFG->EXTICR[Indx] |= (uint32_t)0b0010 << Offset;
        // Configure EXTI line
        uint32_t IrqMsk = 1 << APinNumber;
        EXTI->IMR  |=  IrqMsk;      // Interrupt mode enabled
        EXTI->EMR  &= ~IrqMsk;      // Event mode disabled
        SetTriggerType(ATriggerType);
        EXTI->PR    =  IrqMsk;      // Clean irq flag
        // Get IRQ channel
        if      ((APinNumber >= 0)  and (APinNumber <= 4))  IIrqChnl = EXTI0_IRQn + APinNumber;
        else if ((APinNumber >= 5)  and (APinNumber <= 9))  IIrqChnl = EXTI9_5_IRQn;
        else if ((APinNumber >= 10) and (APinNumber <= 15)) IIrqChnl = EXTI15_10_IRQn;
    }
    void EnableIrq(const uint32_t Priority) { nvicEnableVector(IIrqChnl, CORTEX_PRIORITY_MASK(Priority)); }
    void DisableIrq() { nvicDisableVector(IIrqChnl); }
    void CleanIrqFlag() { EXTI->PR = (1 << IPinNumber); }
};
#endif // EXTI
#endif

#if 1 // ============================== Timers =================================
enum TmrTrigInput_t {tiITR0=0x00, tiITR1=0x10, tiITR2=0x20, tiITR3=0x30, tiTIED=0x40, tiTI1FP1=0x50, tiTI2FP2=0x60, tiETRF=0x70};
enum TmrMasterMode_t {mmReset=0x00, mmEnable=0x10, mmUpdate=0x20, mmComparePulse=0x30, mmCompare1=0x40, mmCompare2=0x50, mmCompare3=0x60, mmCompare4=0x70};
enum TmrSlaveMode_t {smDisable=0, smEncoder1=1, smEncoder2=2, smEncoder3=3, smReset=4, smGated=5, smTrigger=6, smExternal=7};
enum Inverted_t {invNotInverted, invInverted};
enum ExtTrigPol_t {etpInverted=0x8000, etpNotInverted=0x0000};
enum ExtTrigPsc_t {etpOff=0x0000, etpDiv2=0x1000, etpDiv4=0x2000, etpDiv8=0x30000};

class Timer_t {
private:
    TIM_TypeDef* ITmr;
    uint32_t *PClk;
public:
    volatile uint32_t *PCCR;    // Made public to allow DMA
    // Common
    void Init(TIM_TypeDef* Tmr);
    void Deinit();
    void Enable()  { ITmr->CR1 |=  TIM_CR1_CEN; }
    void Disable() { ITmr->CR1 &= ~TIM_CR1_CEN; }
    void SetTopValue(uint16_t Value) { ITmr->ARR = Value; }
    void SetCounter(uint16_t Value) { ITmr->CNT = Value; }
    uint16_t GetCounter() { return ITmr->CNT; }
    uint16_t GetTopValue() { return ITmr->ARR; }
    void SetPrescaler(uint16_t Value) { ITmr->PSC = Value; }
    void SetUpdateFreq(uint32_t FreqHz) {
        uint32_t ClkCnt = *PClk / (ITmr->PSC + 1);
        SetTopValue((ClkCnt / FreqHz) - 1);
    }
    void SetCounterFreq(uint32_t CounterFreqHz) { ITmr->PSC = (*PClk / CounterFreqHz) - 1; }
    // Master/Slave
    void SetTriggerInput(TmrTrigInput_t TrgInput) {
        uint16_t tmp = ITmr->SMCR;
        tmp &= ~TIM_SMCR_TS;   // Clear bits
        tmp |= (uint16_t)TrgInput;
        ITmr->SMCR = tmp;
    }
    void SelectMasterMode(TmrMasterMode_t MasterMode) {
        uint16_t tmp = ITmr->CR2;
        tmp &= ~TIM_CR2_MMS;
        tmp |= (uint16_t)MasterMode;
        ITmr->CR2 = tmp;
    }
    void SelectSlaveMode(TmrSlaveMode_t SlaveMode) {
        uint16_t tmp = ITmr->SMCR;
        tmp &= ~TIM_SMCR_SMS;
        tmp |= (uint16_t)SlaveMode;
        ITmr->SMCR = tmp;
    }
    void EnableExternalClk(ExtTrigPol_t ExtTrigPol = etpNotInverted, ExtTrigPsc_t ExtTrigPsc = etpOff) { ITmr->SMCR = (uint16_t)ExtTrigPol | (uint16_t)ExtTrigPsc | TIM_SMCR_ECE; }
    // DMA, Irq, Evt
    void EnableDmaOnTrigger() { ITmr->DIER |= TIM_DIER_TDE; }
    void GenerateUpdateEvt()  { ITmr->EGR = TIM_EGR_UG; }
    void EnableIrqOnUpdate()  { ITmr->DIER |= TIM_DIER_UIE; }
    void ClearIrqBits()       { ITmr->SR = 0; }
    // PWM
    void InitPwm(GPIO_TypeDef *GPIO, uint16_t N, uint8_t Chnl, Inverted_t Inverted, const PinSpeed_t ASpeed = ps10MHz);
    void SetPwm(uint16_t Value) { *PCCR = Value; }
};
#endif

#if 0 // ============================== IWDG ===================================
enum IwdgPre_t {
    iwdgPre4 = 0x00,
    iwdgPre8 = 0x01,
    iwdgPre16 = 0x02,
    iwdgPre32 = 0x03,
    iwdgPre64 = 0x04,
    iwdgPre128 = 0x05,
    iwdgPre256 = 0x06
};

class IWDG_t {
private:
    void EnableAccess() { IWDG->KR = 0x5555; }
    void SetPrescaler(IwdgPre_t Prescaler) { IWDG->PR = (uint32_t)Prescaler; }
    void SetReload(uint16_t Reload) { IWDG->RLR = Reload; }
public:
    void Reload() { IWDG->KR = 0xAAAA; }
    void Enable() { IWDG->KR = 0xCCCC; }
    void SetTimeout(uint32_t ms) {
        EnableAccess();
        SetPrescaler(iwdgPre256);
        uint32_t Count = (ms * (LSI_FREQ_HZ/1000)) / 256;
        TRIM_VALUE(Count, 0xFFF);
        SetReload(Count);
        Reload();
    }
    bool ResetOccured() {
        if(RCC->CSR & RCC_CSR_IWDGRSTF) {
            RCC->CSR |= RCC_CSR_RMVF;   // Clear flags
            return true;
        }
        else return false;
    }
    void GoSleep(uint32_t Timeout_ms) {
        chSysLock();
        // Start LSI
        Clk.EnableLSI();
        // Start IWDG
        SetTimeout(Timeout_ms);
        Enable();
        // Enter standby mode
        SCB->SCR |= SCB_SCR_SLEEPDEEP;
        PWR->CR = PWR_CR_PDDS;
        PWR->CR |= PWR_CR_CWUF;
        __WFI();
        chSysUnlock();
    }
};
#endif

#if 1 // ============================== SPI ====================================
enum CPHA_t {cphaFirstEdge, cphaSecondEdge};
enum CPOL_t {cpolIdleLow, cpolIdleHigh};
enum SpiBaudrate_t {
    sbFdiv2   = 0b000,
    sbFdiv4   = 0b001,
    sbFdiv8   = 0b010,
    sbFdiv16  = 0b011,
    sbFdiv32  = 0b100,
    sbFdiv64  = 0b101,
    sbFdiv128 = 0b110,
    sbFdiv256 = 0b111,
};

class Spi_t {
private:
    SPI_TypeDef *PSpi;
public:
    void Setup(SPI_TypeDef *Spi, BitOrder_t BitOrder,
            CPOL_t CPOL, CPHA_t CPHA, SpiBaudrate_t Baudrate) {
        PSpi = Spi;
        // Clocking
        if      (PSpi == SPI1) { rccEnableSPI1(FALSE); }
        else if (PSpi == SPI2) { rccEnableSPI2(FALSE); }
        // Mode: Master, NSS software controlled and is 1, 8bit, NoCRC, FullDuplex
        PSpi->CR1 = SPI_CR1_SSM | SPI_CR1_SSI | SPI_CR1_MSTR;
        if(BitOrder == boLSB) PSpi->CR1 |= SPI_CR1_LSBFIRST;    // MSB/LSB
        if(CPOL == cpolIdleHigh) PSpi->CR1 |= SPI_CR1_CPOL;     // CPOL
        if(CPHA == cphaSecondEdge) PSpi->CR1 |= SPI_CR1_CPHA;   // CPHA
        PSpi->CR1 |= ((uint16_t)Baudrate) << 3;                 // Baudrate
        PSpi->CR2 = 0;
        PSpi->I2SCFGR &= ~((uint16_t)SPI_I2SCFGR_I2SMOD);       // Disable I2S
    }
    void Enable () { PSpi->CR1 |=  SPI_CR1_SPE; }
    void Disable() { PSpi->CR1 &= ~SPI_CR1_SPE; }
    void EnableTxDma() { PSpi->CR2 |= SPI_CR2_TXDMAEN; }
    void WaitBsyHi2Lo() { while(PSpi->SR & SPI_SR_BSY); }
    uint8_t ReadWriteByte(uint8_t AByte) {
        PSpi->DR = AByte;
        while(!(PSpi->SR & SPI_SR_RXNE));  // Wait for SPI transmission to complete
        return PSpi->DR;
    }
};
#endif

#if 1 // ============================== I2C ====================================
#define I2C_DMATX_MODE  DMA_PRIORITY_LOW | \
                        STM32_DMA_CR_MSIZE_BYTE | \
                        STM32_DMA_CR_PSIZE_BYTE | \
                        STM32_DMA_CR_MINC |     /* Memory pointer increase */ \
                        STM32_DMA_CR_DIR_M2P |  /* Direction is memory to peripheral */ \
                        STM32_DMA_CR_TCIE       /* Enable Transmission Complete IRQ */

#define I2C_DMARX_MODE  DMA_PRIORITY_LOW | \
                        STM32_DMA_CR_MSIZE_BYTE | \
                        STM32_DMA_CR_PSIZE_BYTE | \
                        STM32_DMA_CR_MINC |         /* Memory pointer increase */ \
                        STM32_DMA_CR_DIR_P2M |      /* Direction is peripheral to memory */ \
                        STM32_DMA_CR_TCIE           /* Enable Transmission Complete IRQ */

class i2c_t {
private:
    I2C_TypeDef *ii2c;
    GPIO_TypeDef *IPGpio;
    uint16_t ISclPin, ISdaPin;
    uint32_t IBitrateHz;
    void SendStart()     { ii2c->CR1 |= I2C_CR1_START; }
    void SendStop()      { ii2c->CR1 |= I2C_CR1_STOP; }
    void AckEnable()     { ii2c->CR1 |= I2C_CR1_ACK; }
    void AckDisable()    { ii2c->CR1 &= ~I2C_CR1_ACK; }
    bool RxIsNotEmpty()  { return (ii2c->SR1 & I2C_SR1_RXNE); }
    void ClearAddrFlag() { (void)ii2c->SR1; (void)ii2c->SR2; }
    void DmaLastTransferSet() { ii2c->CR2 |= I2C_CR2_LAST; }
    // Address and data
    void SendAddrWithWrite(uint8_t Addr) { ii2c->DR = (uint8_t)(Addr<<1); }
    void SendAddrWithRead (uint8_t Addr) { ii2c->DR = ((uint8_t)(Addr<<1)) | 0x01; }
    void SendData(uint8_t b) { ii2c->DR = b; }
    uint8_t ReceiveData() { return ii2c->DR; }
    // Flags operations
    uint8_t IBusyWait();
    uint8_t WaitEv5();
    uint8_t WaitEv6();
    uint8_t WaitEv8();
    uint8_t WaitAck();
    uint8_t WaitRx();
    uint8_t WaitStop();
    uint8_t WaitBTF();
public:
    bool Error;
    Thread *PRequestingThread;
    const stm32_dma_stream_t *PDmaTx, *PDmaRx;
    void Init(I2C_TypeDef *pi2c, GPIO_TypeDef *PGpio, uint16_t SclPin, uint16_t SdaPin, uint32_t BitrateHz,
            const stm32_dma_stream_t *APDmaTx, const stm32_dma_stream_t *APDmaRx);
    void Standby();
    void Resume();
    void Reset();
    uint8_t CmdWriteRead(uint8_t Addr, uint8_t *WPtr, uint8_t WLength, uint8_t *RPtr, uint8_t RLength);
    uint8_t CmdWriteWrite(uint8_t Addr, uint8_t *WPtr1, uint8_t WLength1, uint8_t *WPtr2, uint8_t WLength2);
};
#endif

#if 1 // ====================== FLASH & EEPROM =================================
#define FLASH_LIB_KL
#define EEPROM_BASE_ADDR    ((uint32_t)0x08080000)
// ==== Flash keys ====
#define FLASH_PDKEY1    ((uint32_t)0x04152637) // Flash power down key1
// Flash power down key2: used with FLASH_PDKEY1 to unlock the RUN_PD bit in FLASH_ACR
#define FLASH_PDKEY2    ((uint32_t)0xFAFBFCFD)
#define FLASH_PEKEY1    ((uint32_t)0x89ABCDEF) // Flash program erase key1
// Flash program erase key: used with FLASH_PEKEY2 to unlock the write access
// to the FLASH_PECR register and data EEPROM
#define FLASH_PEKEY2    ((uint32_t)0x02030405)
#define FLASH_PRGKEY1   ((uint32_t)0x8C9DAEBF) // Flash program memory key1
// Flash program memory key2: used with FLASH_PRGKEY2 to unlock the program memory
#define FLASH_PRGKEY2   ((uint32_t)0x13141516)
#define FLASH_OPTKEY1   ((uint32_t)0xFBEAD9C8) // Flash option key1
// Flash option key2: used with FLASH_OPTKEY1 to unlock the write access to the option byte block
#define FLASH_OPTKEY2   ((uint32_t)0x24252627)

#define FLASH_WAIT_TIMEOUT  36000
class Flash_t {
protected:
    static uint8_t GetStatus() {
        if(FLASH->SR & FLASH_SR_BSY) return BUSY;
        else if(FLASH->SR & FLASH_SR_WRPERR) return WRITE_PROTECT;
        else if(FLASH->SR & (uint32_t)0x1E00) return FAILURE;
        else return OK;
    }
    static uint8_t WaitForLastOperation() {
        uint32_t Timeout = FLASH_WAIT_TIMEOUT;
        while(Timeout--) {
            // Get status
            uint8_t status = GetStatus();
            if(status != BUSY) return status;
        }
        return TIMEOUT;
    }
    static void UnlockEE() {
        if(FLASH->PECR & FLASH_PECR_PELOCK) {
            // Unlocking the Data memory and FLASH_PECR register access
            chSysLock();
            FLASH->PEKEYR = FLASH_PEKEY1;
            FLASH->PEKEYR = FLASH_PEKEY2;
            chSysUnlock();
            FLASH->SR = FLASH_SR_WRPERR;        // Clear WriteProtectErr
            FLASH->PECR &= ~FLASH_PECR_FTDW;    // Disable fixed time programming
        }
    }
    static void LockEE() { FLASH->PECR |= FLASH_PECR_PELOCK; }
};

class Eeprom_t : private Flash_t {
public:
    uint32_t Read32(uint32_t Addr) { return *((uint32_t*)(Addr + EEPROM_BASE_ADDR)); }
    uint8_t Write32(uint32_t Addr, uint32_t W);
    void ReadBuf(void *PDst, uint32_t Sz, uint32_t Addr);
    uint8_t WriteBuf(void *PSrc, uint32_t Sz, uint32_t Addr);
};


#endif

#endif /* KL_LIB_F100_H_ */
