aeremin/chibi-armlet/Firmware/Common/cc1101.cpp

/*
 * cc1101.cpp
 *
 *  Created on: Feb 12, 2013
 *      Author: g.kruglov
 */

#include "cc1101.h"
#include "ch.h"

cc1101_t CC;

void cc1101_t::Init() {
    // ==== GPIO ====
    PinSetupOut      (CC_GPIO, CC_CS,   omPushPull);
    PinSetupAlterFunc(CC_GPIO, CC_SCK,  omPushPull, pudNone, AF5);
    PinSetupAlterFunc(CC_GPIO, CC_MISO, omPushPull, pudNone, AF5);
    PinSetupAlterFunc(CC_GPIO, CC_MOSI, omPushPull, pudNone, AF5);
    PinSetupIn       (CC_GPIO, CC_GDO0, pudNone);
    PinSetupIn       (CC_GPIO, CC_GDO2, pudNone);
    CsHi();

    // ==== SPI ====    MSB first, master, ClkLowIdle, FirstEdge, Baudrate=f/2
    Spi_t::Setup(CC_SPI, boMSB, cpolIdleLow, cphaFirstEdge, sbFdiv2);
    Spi_t::Enable(CC_SPI);

    // ==== Init CC ====
    CReset();
    FlushRxFIFO();
    RfConfig();
    PWaitingThread = nullptr;
    State = ccIdle;

    // ==== IRQ ====
    IGdo0.Setup(CC_GPIO, CC_GDO0, ttFalling);
    IGdo0.EnableIRQ(IRQ_PRIO_MEDIUM);
}

// ========================== TX, RX, freq and power ===========================
void cc1101_t::SetChannel(uint8_t AChannel) {
    while(IState != CC_STB_IDLE) EnterIdle();   // CC must be in IDLE mode
    WriteRegister(CC_CHANNR, AChannel);         // Now set channel
}

//void cc1101_t::WaitUntilChannelIsBusy() {
//    uint8_t b;
//    for(uint32_t i=0; i<207; i++) {
//        b = ReadRegister(CC_PKTSTATUS);
//        if(b & 0b00010000) break;
//        //Uart.Printf("C");
//    }
//    //Uart.Printf("\r");
//}

void cc1101_t::TransmitSync(rPkt_t *pPkt) {
    // WaitUntilChannelIsBusy();   // If this is not done, time after time FIFO is destroyed
    while(IState != CC_STB_IDLE) EnterIdle();
    WriteTX((uint8_t*)pPkt, RPKT_LEN);
    // Enter TX and wait IRQ
    chSysLock();
    EnterTX();
    PWaitingThread = chThdSelf();
    chSchGoSleepS(THD_STATE_SUSPENDED);
    chSysUnlock();  // Will be here when IRQ fires
}

void cc1101_t::TransmitAsync(rPkt_t *pPkt) {
    // WaitUntilChannelIsBusy();   // If this is not done, time after time FIFO is destroyed
    PWaitingThread = NULL;
    State = ccTransmitting;
    while(IState != CC_STB_IDLE) EnterIdle();
    WriteTX((uint8_t*)pPkt, RPKT_LEN);
    EnterTX();
}

/*
 * Enter RX mode and wait reception for Timeout_ms.
 */
uint8_t cc1101_t::ReceiveSync(uint32_t Timeout_ms, rPkt_t *pPkt) {
    FlushRxFIFO();
    chSysLock();
    EnterRX();      // After that, some time will be wasted to recalibrate if enabled
    PWaitingThread = chThdSelf();
    msg_t Rslt = chSchGoSleepTimeoutS(THD_STATE_SUSPENDED, MS2ST(Timeout_ms));
    chSysUnlock();  // Will be here when IRQ will fire, or timeout occur - with appropriate message

    if(Rslt == RDY_TIMEOUT) {   // Nothing received, timeout occured
        EnterIdle();            // Get out of RX mode
        return TIMEOUT;
    }
    // IRQ occured: something received, or CRC error
    else return ReadFIFO(pPkt);
}

void cc1101_t::ReceiveAsync() {
    PWaitingThread = NULL;
    State = ccReceiving;
    FlushRxFIFO();
    EnterRX();
}

// Return RSSI in dBm
int8_t cc1101_t::RSSI_dBm(uint8_t ARawRSSI) {
    int16_t RSSI = ARawRSSI;
    if (RSSI >= 128) RSSI -= 256;
    RSSI = (RSSI / 2) - 74;    // now it is in dBm
    return RSSI;
}


uint8_t cc1101_t::ReadFIFO(rPkt_t *pPkt) {
    uint8_t b, *p = (uint8_t*)pPkt;
     // Check if received successfully
     b = ReadRegister(CC_PKTSTATUS);
     //    Uart.Printf("St: %X  ", b);
     if(b & 0x80) {  // CRC OK
         // Read FIFO
         CsLo();                                            // Start transmission
         BusyWait();                                        // Wait for chip to become ready
         ReadWriteByte(CC_FIFO|CC_READ_FLAG|CC_BURST_FLAG); // Address with read & burst flags
         for(uint8_t i=0; i<RPKT_LEN; i++) {                // Read bytes
             b = ReadWriteByte(0);
             *p++ = b;
             // Uart.Printf(" %X", b);
         }
         // Receive two additional info bytes
         b = ReadWriteByte(0);   // RSSI
         ReadWriteByte(0);       // LQI
         CsHi();                 // End transmission
         pPkt->RSSI = RSSI_dBm(b);
         return OK;
     }
     else return FAILURE;
}

// =========================== Registers & Strobes =============================
uint8_t cc1101_t::ReadWriteByte(uint8_t AByte) {
    CC_SPI->DR = AByte;
    while(!(CC_SPI->SR & SPI_SR_RXNE));  // Wait for SPI transmission to complete
    return CC_SPI->DR;
}

uint8_t cc1101_t::ReadRegister (uint8_t ARegAddr){
    CsLo();                                 // Start transmission
    BusyWait();                             // Wait for chip to become ready
    ReadWriteByte(ARegAddr | CC_READ_FLAG); // Transmit header byte
    uint8_t FReply = ReadWriteByte(0);      // Read reply
    CsHi();                                 // End transmission
    return FReply;
}
void cc1101_t::WriteRegister (uint8_t ARegAddr, uint8_t AData){
    CsLo();                     // Start transmission
    BusyWait();                 // Wait for chip to become ready
    ReadWriteByte(ARegAddr);    // Transmit header byte
    ReadWriteByte(AData);       // Write data
    CsHi();                     // End transmission
}
void cc1101_t::WriteStrobe (uint8_t AStrobe){
    CsLo();                             // Start transmission
    BusyWait();                         // Wait for chip to become ready
    IState = ReadWriteByte(AStrobe);    // Write strobe
    CsHi();                             // End transmission
    IState &= 0b01110000;               // Mask needed bits
}

void cc1101_t::WriteTX(uint8_t* Ptr, uint8_t Length) {
    CsLo();                                                 // Start transmission
    BusyWait();                                             // Wait for chip to become ready
    ReadWriteByte(CC_FIFO|CC_WRITE_FLAG|CC_BURST_FLAG);     // Address with write & burst flags
    uint8_t b;
    //Uart.Printf("TX: ");
    for (uint8_t i=0; i<Length; i++) {
        b = *Ptr++;
        ReadWriteByte(b);  // Write bytes
      //  Uart.Printf("%X ", b);
    }
    CsHi();    // End transmission
    //Uart.Printf("\r");
}

// ==== Used to setup CC with needed values ====
void cc1101_t::RfConfig() {
    WriteRegister(CC_FSCTRL1,  CC_FSCTRL1_VALUE);    // Frequency synthesizer control.
    WriteRegister(CC_FSCTRL0,  CC_FSCTRL0_VALUE);    // Frequency synthesizer control.
    WriteRegister(CC_FREQ2,    CC_FREQ2_VALUE);      // Frequency control word, high byte.
    WriteRegister(CC_FREQ1,    CC_FREQ1_VALUE);      // Frequency control word, middle byte.
    WriteRegister(CC_FREQ0,    CC_FREQ0_VALUE);      // Frequency control word, low byte.
    WriteRegister(CC_MDMCFG4,  CC_MDMCFG4_VALUE);    // Modem configuration.
    WriteRegister(CC_MDMCFG3,  CC_MDMCFG3_VALUE);    // Modem configuration.
    WriteRegister(CC_MDMCFG2,  CC_MDMCFG2_VALUE);    // Modem configuration.
    WriteRegister(CC_MDMCFG1,  CC_MDMCFG1_VALUE);    // Modem configuration.
    WriteRegister(CC_MDMCFG0,  CC_MDMCFG0_VALUE);    // Modem configuration.
    WriteRegister(CC_CHANNR,   CC_CHANNR_VALUE);     // Channel number.
    WriteRegister(CC_DEVIATN,  CC_DEVIATN_VALUE);    // Modem deviation setting (when FSK modulation is enabled).
    WriteRegister(CC_FREND1,   CC_FREND1_VALUE);     // Front end RX configuration.
    WriteRegister(CC_FREND0,   CC_FREND0_VALUE);     // Front end RX configuration.
    WriteRegister(CC_MCSM0,    CC_MCSM0_VALUE);      // Main Radio Control State Machine configuration.
    WriteRegister(CC_FOCCFG,   CC_FOCCFG_VALUE);     // Frequency Offset Compensation Configuration.
    WriteRegister(CC_BSCFG,    CC_BSCFG_VALUE);      // Bit synchronization Configuration.
    WriteRegister(CC_AGCCTRL2, CC_AGCCTRL2_VALUE);   // AGC control.
    WriteRegister(CC_AGCCTRL1, CC_AGCCTRL1_VALUE);   // AGC control.
    WriteRegister(CC_AGCCTRL0, CC_AGCCTRL0_VALUE);   // AGC control.
    WriteRegister(CC_FSCAL3,   CC_FSCAL3_VALUE);     // Frequency synthesizer calibration.
    WriteRegister(CC_FSCAL2,   CC_FSCAL2_VALUE);     // Frequency synthesizer calibration.
    WriteRegister(CC_FSCAL1,   CC_FSCAL1_VALUE);     // Frequency synthesizer calibration.
    WriteRegister(CC_FSCAL0,   CC_FSCAL0_VALUE);     // Frequency synthesizer calibration.
    WriteRegister(CC_TEST2,    CC_TEST2_VALUE);      // Various test settings.
    WriteRegister(CC_TEST1,    CC_TEST1_VALUE);      // Various test settings.
    WriteRegister(CC_TEST0,    CC_TEST0_VALUE);      // Various test settings.
    WriteRegister(CC_FIFOTHR,  CC_FIFOTHR_VALUE);    // fifo threshold
    WriteRegister(CC_IOCFG2,   CC_IOCFG2_VALUE);     // GDO2 output pin configuration.
    WriteRegister(CC_IOCFG0,   CC_IOCFG0_VALUE);     // GDO0 output pin configuration.
    WriteRegister(CC_PKTCTRL1, CC_PKTCTRL1_VALUE);   // Packet automation control.
    WriteRegister(CC_PKTCTRL0, CC_PKTCTRL0_VALUE);   // Packet automation control.
    WriteRegister(CC_PKTLEN,   RPKT_LEN);            // Packet length, dummy

    WriteRegister(CC_PATABLE, CC_PATABLE_INITIAL);

    WriteRegister(CC_MCSM2, CC_MCSM2_VALUE);
    WriteRegister(CC_MCSM1, CC_MCSM1_VALUE);
}

// ============================= Interrupts ====================================
void cc1101_t::IHandleAsync() {
    if(State == ccTransmitting) {
        State = ccIdle;
//        chEvtBroadcastI(&IEvtSrcTx);  // FIXME
    }
    else if(State == ccReceiving) {
        State = ccIdle;
//        chEvtBroadcastI(&IEvtSrcRx);  // FIXME
    }
}

void cc1101_t::IGdo0IrqHandler() {
    IGdo0.CleanIrqFlag();
    // Resume thread if any
    chSysLockFromIsr();
    if(PWaitingThread != NULL) {
        if(PWaitingThread->p_state == THD_STATE_SUSPENDED) {
            PWaitingThread->p_u.rdymsg = RDY_OK;    // Signal that IRQ fired
            chSchReadyI(PWaitingThread);
        }
        PWaitingThread = NULL;
    }
    else IHandleAsync(); // Async task completed
    chSysUnlockFromIsr();
}

extern "C" {
CH_IRQ_HANDLER(GDO0_IRQ_HANLER) {
    CH_IRQ_PROLOGUE();
    CC.IGdo0IrqHandler();
    CH_IRQ_EPILOGUE();
}
} // extern c
