aeremin/chibi-armlet/Firmware/kl_lib/clocking_L100.cpp

/*
 * clocking.cpp
 *
 *  Created on: 20.01.2013
 *      Author: kreyl
 */

#include "clocking_L15x.h"
#include "stm32_rcc.h"

Clk_t Clk;

// ==== Inner use ====
uint8_t Clk_t::HSEEnable() {
    RCC->CR |= RCC_CR_HSEON;    // Enable HSE
    // Wait until ready
    uint32_t StartUpCounter=0;
    do {
        if(RCC->CR & RCC_CR_HSERDY) return 0;   // HSE is ready
        StartUpCounter++;
    } while(StartUpCounter < HSE_STARTUP_TIMEOUT);
    return 1; // Timeout
}

uint8_t Clk_t::HSIEnable() {
    RCC->CR |= RCC_CR_HSION;
    // Wait until ready
    uint32_t StartUpCounter=0;
    do {
        if(RCC->CR & RCC_CR_HSIRDY) return 0;   // HSI is ready
        StartUpCounter++;
    } while(StartUpCounter < HSE_STARTUP_TIMEOUT);
    return 1; // Timeout
}

uint8_t Clk_t::PLLEnable() {
    RCC->CR |= RCC_CR_PLLON;
    // Wait until ready
    uint32_t StartUpCounter=0;
    do {
        if(RCC->CR & RCC_CR_PLLRDY) return 0;   // PLL is ready
        StartUpCounter++;
    } while(StartUpCounter < HSE_STARTUP_TIMEOUT);
    return 1; // Timeout
}

uint8_t Clk_t::MSIEnable() {
    RCC->CR |= RCC_CR_MSION;
    // Wait until ready
    uint32_t StartUpCounter=0;
    do {
        if(RCC->CR & RCC_CR_MSIRDY) return 0;   // MSI is ready
        StartUpCounter++;
    } while(StartUpCounter < HSE_STARTUP_TIMEOUT);
    return 1; // Timeout
}

void Clk_t::UpdateFreqValues() {
    uint32_t tmp, PllMul, PllDiv;
    uint32_t SysClkHz;
    // Tables
    const uint32_t MSIClk[8] = {65536, 131072, 262144, 524188, 1048000, 2097000, 4194000};
    const uint8_t PllMulTable[9] = {3, 4, 6, 8, 12, 16, 24, 32, 48};
    const uint8_t AHBPrescTable[16] = {0, 0, 0, 0, 0, 0, 0, 0, 1, 2, 3, 4, 6, 7, 8, 9};
    const uint8_t APBPrescTable[8] = {0, 0, 0, 0, 1, 2, 3, 4};

    // Figure out SysClk
    tmp = RCC->CFGR & RCC_CFGR_SWS;
    tmp >>= 2;
    switch(tmp) {
        case 0b00: // MSI
            tmp = (RCC->ICSCR & RCC_ICSCR_MSIRANGE) >> 13;
            SysClkHz = MSIClk[tmp];
            break;

        case 0b01: // HSI
            SysClkHz = HSI_FREQ_HZ;
            break;

        case 0b10: // HSE
            SysClkHz = CRYSTAL_FREQ_HZ;
            break;

        case 0b11: // PLL used as system clock source
            // Get different PLL dividers
            tmp = (RCC->CFGR & RCC_CFGR_PLLMUL) >> 18;
            PllMul = PllMulTable[tmp];
            PllDiv = ((RCC->CFGR & RCC_CFGR_PLLDIV) >> 22) +1;
            // Which src is used as pll input?
            SysClkHz = ((RCC->CFGR & RCC_CFGR_PLLSRC) == RCC_CFGR_PLLSRC_HSI)? HSI_FREQ_HZ : CRYSTAL_FREQ_HZ;
            SysClkHz = (SysClkHz * PllMul) / PllDiv;
            break;
    } // switch

    // AHB freq
    tmp = AHBPrescTable[((RCC->CFGR & RCC_CFGR_HPRE) >> 4)];
    AHBFreqHz = SysClkHz >> tmp;
    // APB freq
    tmp = APBPrescTable[(RCC->CFGR & RCC_CFGR_PPRE1) >> 8];
    APB1FreqHz = AHBFreqHz >> tmp;
    tmp = APBPrescTable[(RCC->CFGR & RCC_CFGR_PPRE2) >> 11];
    APB2FreqHz = AHBFreqHz >> tmp;
}

// ==== Common use ====
// AHB, APB
void Clk_t::SetupBusDividers(AHBDiv_t AHBDiv, APBDiv_t APB1Div, APBDiv_t APB2Div) {
    // Setup dividers
    uint32_t tmp = RCC->CFGR;
    tmp &= ~(RCC_CFGR_HPRE | RCC_CFGR_PPRE1 | RCC_CFGR_PPRE2);  // Clear bits
    tmp |= ((uint32_t)AHBDiv)  << 4;
    tmp |= ((uint32_t)APB1Div) << 8;
    tmp |= ((uint32_t)APB2Div) << 11;
    RCC->CFGR = tmp;
}

// Enables HSI, switches to HSI
uint8_t Clk_t::SwitchToHSI() {
    if(HSIEnable() != 0) return 1;
    uint32_t tmp = RCC->CFGR;
    tmp &= ~RCC_CFGR_SW;
    tmp |=  RCC_CFGR_SW_HSI;  // Select HSI as system clock src
    RCC->CFGR = tmp;
    while((RCC->CFGR & RCC_CFGR_SWS) != RCC_CFGR_SWS_HSI); // Wait till ready
    return 0;
}

// Enables HSE, switches to HSE
uint8_t Clk_t::SwitchToHSE() {
    if(HSEEnable() != 0) return 1;
    uint32_t tmp = RCC->CFGR;
    tmp &= ~RCC_CFGR_SW;
    tmp |=  RCC_CFGR_SW_HSE;  // Select HSE as system clock src
    RCC->CFGR = tmp;
    while((RCC->CFGR & RCC_CFGR_SWS) != RCC_CFGR_SWS_HSE); // Wait till ready
    return 0;
}

// Enables HSE, enables PLL, switches to PLL
uint8_t Clk_t::SwitchToPLL() {
    if(HSEEnable() != 0) return 1;
    if(PLLEnable() != 0) return 2;
    uint32_t tmp = RCC->CFGR;
    tmp &= ~RCC_CFGR_SW;
    tmp |=  RCC_CFGR_SW_PLL;      // Select PLL as system clock src
    RCC->CFGR = tmp;
    while((RCC->CFGR & RCC_CFGR_SWS) != RCC_CFGR_SWS_PLL); // Wait until ready
    return 0;
}

// Enables MSI, switches to MSI
uint8_t Clk_t::SwitchToMSI() {
    if(MSIEnable() != 0) return 1;
    uint32_t tmp = RCC->CFGR;
    tmp &= ~RCC_CFGR_SW;
    tmp |=  RCC_CFGR_SW_MSI;      // Select MSI as system clock src
    RCC->CFGR = tmp;
    while((RCC->CFGR & RCC_CFGR_SWS) != RCC_CFGR_SWS_MSI); // Wait until ready
    return 0;
}

// Disable PLL first!
// HsePreDiv: 1...16; PllMul: pllMul[]
uint8_t Clk_t::SetupPLLMulDiv(PllMul_t PllMul, PllDiv_t PllDiv) {
    if(RCC->CR & RCC_CR_PLLON) return 1;    // PLL must be disabled to change dividers
    uint32_t tmp = RCC->CFGR;
    tmp &= RCC_CFGR_PLLDIV | RCC_CFGR_PLLMUL;
    tmp |= ((uint32_t)PllDiv) << 22;
    tmp |= ((uint32_t)PllMul) << 18;
    tmp |= RCC_CFGR_PLLSRC_HSE;
    RCC->CFGR = tmp;
    return 0;
}

void Clk_t::SetupFlashLatency(uint8_t AHBClk_MHz) {
    FLASH->ACR |= FLASH_ACR_ACC64;  // Enable 64-bit access
    FLASH->ACR |= FLASH_ACR_PRFTEN; // May be written only when ACC64 is already set
    if(     ((VCore == vcore1V2) and (AHBClk_MHz > 2)) or
            ((VCore == vcore1V5) and (AHBClk_MHz > 8)) or
            ((VCore == vcore1V8) and (AHBClk_MHz > 16))
            ) {
        FLASH->ACR |= FLASH_ACR_LATENCY;
    }
    else FLASH->ACR &= ~FLASH_ACR_LATENCY;
}

//void Clk_t::SetupAdcClk(ADCDiv_t ADCDiv) {
//    uint32_t tmp = RCC->CFGR;
//    tmp &= ~RCC_CFGR_ADCPRE;
//    tmp |= (uint32_t)ADCDiv;
//    RCC->CFGR = tmp;
//}

// =============================== V Core ======================================
VCore_t VCore;
void SetupVCore(VCore_t AVCore) {
    // PWR clock enable
    RCC->APB1ENR = RCC_APB1ENR_PWREN;
    // Core voltage setup
    while((PWR->CSR & PWR_CSR_VOSF) != 0); // Wait until regulator is stable
    uint32_t tmp = PWR->CR;
    tmp &= ~PWR_CR_VOS;
    tmp |= ((uint32_t)AVCore) << 11;
    PWR->CR = tmp;
    while((PWR->CSR & PWR_CSR_VOSF) != 0); // Wait until regulator is stable
}

///*
// * Early initialization code.
// * This initialization must be performed just after stack setup and before
// * any other initialization.
// */
//void __early_init(void) {
//    // Enable HSI. It is enabled by default, but who knows.
//    RCC->CR |= RCC_CR_HSION;
//    while(!(RCC->CR & RCC_CR_HSIRDY));
//}
