aeremin/chibi-armlet/Firmware/Radio/radio_lvl1.cpp

/*
 * radio_lvl1.cpp
 *
 *  Created on: Nov 17, 2013
 *      Author: kreyl
 */

#include "radio_lvl1.h"
#include "cc1101.h"
#include "uart.h"
#include "main.h"

#include "led.h"
#include "Sequences.h"
extern LedRGBwPower_t Led;

cc1101_t CC(CC_Setup0);


//#define DBG_PINS

#ifdef DBG_PINS
#define DBG_GPIO1   GPIOB
#define DBG_PIN1    10
#define DBG1_SET()  PinSetHi(DBG_GPIO1, DBG_PIN1)
#define DBG1_CLR()  PinSetLo(DBG_GPIO1, DBG_PIN1)
#define DBG_GPIO2   GPIOB
#define DBG_PIN2    9
#define DBG2_SET()  PinSetHi(DBG_GPIO2, DBG_PIN2)
#define DBG2_CLR()  PinSetLo(DBG_GPIO2, DBG_PIN2)
#else
#define DBG1_SET()
#define DBG1_CLR()
#endif

rLevel1_t Radio;

#if 1 // ================================ Task =================================
static THD_WORKING_AREA(warLvl1Thread, 256);
__noreturn
static void rLvl1Thread(void *arg) {
    chRegSetThreadName("rLvl1");
    while(true) {
        // Iterate channels
        for(int32_t i = CHNL_MIN; i <= CHNL_MAX; i++) {
            CC.SetChannel(i);
            CC.Recalibrate();
            rPkt_t PktRx;
            int8_t Rssi;
            uint8_t RxRslt = CC.Receive(63, &PktRx, RPKT_LEN, &Rssi);
            if(RxRslt == retvOk) {
                Printf("ch=%u; Rssi=%d; ID=%u\r", i, Rssi, PktRx.ID);
                Radio.RxTable.AddId(PktRx.ID);
            }
        } // for i
        Radio.TryToSleep(810);
    } // while true
}

void rLevel1_t::TryToSleep(uint32_t SleepDuration) {
    if(SleepDuration >= MIN_SLEEP_DURATION_MS) CC.EnterPwrDown();
    chThdSleepMilliseconds(SleepDuration);
}
#endif // task

#if 1 // ============================
uint8_t rLevel1_t::Init() {
#ifdef DBG_PINS
    PinSetupOut(DBG_GPIO1, DBG_PIN1, omPushPull);
    PinSetupOut(DBG_GPIO2, DBG_PIN2, omPushPull);
#endif

    RMsgQ.Init();
    if(CC.Init() == retvOk) {
        CC.SetTxPower(CC_Pwr0dBm);
        CC.SetPktSize(RPKT_LEN);
        CC.SetChannel(0);
//        CC.EnterPwrDown();
        // Thread
        chThdCreateStatic(warLvl1Thread, sizeof(warLvl1Thread), HIGHPRIO, (tfunc_t)rLvl1Thread, NULL);
        return retvOk;
    }
    else return retvFail;
}
#endif
