aeremin/chibi-armlet/(commit log)

2013-10-21 Hw added
    [ChibiArmlet.sch]
2013-10-23 First version of sch ready.
    [ChibiArmlet.sch]
2013-10-24 Crystal added
    [ChibiArmlet.sch]
2013-10-26 Still L MCU
    [ChibiArmlet.sch]
2013-10-27 Switch to stm32f051
    [ChibiArmlet.sch]
2013-10-27 Firefly4 with LQFP-48
    [ChibiArmlet.kicad_pcb, ChibiArmlet.sch]
2013-10-27 Back to LQFP48
    [ChibiArmlet.sch]
2013-10-28 MCU replaced with stm32L100c6
    [ChibiArmlet.kicad_pcb, ChibiArmlet.sch]
2013-10-30 Again, buttons and display added.
    [ChibiArmlet.kicad_pcb, ChibiArmlet.sch]
2013-10-30 PCB routed save antenna. Quartz added.
    [ChibiArmlet.kicad_pcb, ChibiArmlet.sch]
2013-10-30 + Antenna + Quartz 32768
    [ChibiArmlet.kicad_pcb, ChibiArmlet.sch]
2013-11-09 Prototype sent to factory
    [ChibiArmlet.kicad_pcb, ChibiArmlet.sch]
2013-11-09 Prints freqs
2013-11-09 + LED RGB: smoothly changes intencity
2013-11-09 + LED blinks sequences
2013-11-09 + application.cpp * debug uart switched to cmd_uart in special file + uart cmd interface + Ping, GetID, SetID + Pill added, not implemented
2013-11-09 + Pill related UART commands + Pill can be read and write + Application checks the pill
2013-11-11 + BOM
    [ChibiArmlet-BOM.xlsx]
2013-11-15 + Dose is loaded from EEPROM at start + Dose is saved to EEPROM time after time + Implemented GetDose/SetDose UART CMDs * Application event-driven, three timers generate timings
2013-11-15 * G.Kruglov switched to Kreyl
2013-11-15 * Beeper & Led sequences changed to be the same + Sequences for pill added * Volume now 0...10 instead of 0...100
2013-11-16 * Debug options on * SysLock mess served, no errors now
    [kl_lib_L15x.cpp, main.cpp]
2013-11-16 * Pill struct changed + Pill cure and charge lowering
2013-11-16 * Pills rewritten: pill manager implemented. + Pill is protected wit semaphore. * At UART RX IRQ flag ORE cleared, as RXNE IRQ enables ORE, too.
2013-11-17 * UART RX with DMA, RX IRQ disabled. Works smoothly.
2013-11-17 * Slight modifications, App reenabled + Uart, Pills etc. seem working ok.
2013-11-21 Lot of deletions
    [ChibiArmlet-BOM.xlsx]
2013-11-22 * Projects switched to new ARM plugin version
2013-11-23 + Two devices sence each other.
2013-11-26 FalloutTX switched to L151
2013-11-26 + Changelog + BOM Request
    [BOM_Request.xlsx]
2013-11-29 * CC Power consts moved to defins
2013-12-02 * Emanator transmits correct pkts, works with device
    [main.cpp, radio_lvl1.cpp]
2013-12-03 * Dmg lowered to make final damage 5.
    [radio_lvl1.cpp]
2013-12-03 * Damage calculated in rlvl1. Calculations clarified.
    [kl_lib_L15x.h, radio_lvl1.cpp]
2013-12-04 + Variative damage at FalloutTX and Detector works ok
    [radio_lvl1.cpp]
2013-12-05 * Damage calculations and emanator iterations moved to h file
    [main.cpp, radio_lvl1.cpp, radio_lvl1.h]
2013-12-05 Device code merged, seems to work.
2013-12-06 + Vibro +Debug Pin * All R 0402 * 10u 0603
    [ChibiArmlet.kicad_pcb, ChibiArmlet.sch]
2013-12-06 - Buttons - LCD - Quartz 32768
    [ChibiArmlet.kicad_pcb, ChibiArmlet.sch]
2013-12-09 + 4-pin connector for functionality raising
    [ChibiArmlet.kicad_pcb, ChibiArmlet.sch]
2013-12-09 Hardware: * Pill connector now 2.54mm, placed near battery
    [ChibiArmlet.kicad_pcb]
2013-12-10 Hardware v3, sent to pilot production
    [ChibiArmlet.kicad_pcb, ChibiArmlet.sch]
2013-12-28 + Vibro and sequences TODO: change sch & PCB to power vibro directly from battery.
2013-12-29 * Vibro disconnected from 3V3, connected to Vbat. * BOM renewed
    [ChibiArmlet-BOM.xlsx, ChibiArmlet.kicad_pcb, ChibiArmlet.sch]
2014-03-31 Pill2 added
    [Pill2.kicad_pcb, Pill2.sch]
2014-03-31 Test firmware
    [Бланк заказа печатных плат.xls]
2014-03-31 Pill request added
    [Бланк заказа печатных плат.xls]
2014-04-01 * kl_libs replaced with newer ones
    [cmd_uart.h, kl_lib_L15x.cpp, kl_lib_L15x.h, main.cpp]
2014-04-01 * EE write fixed (ee unlock added)
    [kl_lib_L15x.cpp]
2014-04-02 * CC low level replaced with one from armlet, and successfully checked * Type setup modified * rpkt changed
    [cc1101.cpp, kl_lib_L15x.h, main.cpp, radio_lvl1.cpp, radio_lvl1.h]
2014-04-02 + SensorTable added
2014-04-04 + Excel with calculations + Special class for calculations
    [ShikoSumming.xlsx]
2014-04-04 Pill2 renamed to Pill3
    [Pill3.kicad_pcb, Pill3.sch]
2014-04-09 + gitignore, Excel Summing
    [ShikoSumming.xlsx]
2014-04-09 Pill3 for Beriozka prepared
    [Pill3.kicad_pcb, ShikoSumming.xlsx, Бланк заказа печатных плат.xls]
2014-04-10 + Pill4 * Indication added
    [Pill4.kicad_pcb, Pill4.sch, Бланк заказа печатных плат.xls]
2014-04-12 + Pill4.zip
    [Бланк заказа печатных плат.xls]
2014-04-16 * Lite changes in UART cmd exec
2014-04-16 + Device type setup with pill
2014-04-16 + Correct fields ignore added
    [main.cpp]
2014-04-23 + Detector seems ok + ADC work started
2014-04-23 + Battery indication completed
2014-05-03 * Move to event-driving concept + Set ID by Pill implemented - Shiko traces removal in progress
2014-05-03 + Pill SetConsts implemented + Uart GetConsts implemented
2014-05-03 + UART Get/Set dose implemented
2014-05-04 * CmdUart thread removed, polling implemented using main thread
2014-05-04 + RxTable; Table received successfully, fixed bug with PutData + Lustra implemented. Debug mode only, all parameters hard-coded.
    [main.cpp, radio_lvl1.cpp, radio_lvl1.h]
2014-05-06 Pill and Uart data xchange switched to Big Endian (number 9 stored now as 00 09, not 09 00). Conversion functions added to lib.
2014-05-07 Uart Cmd switch to text-based protocol
2014-05-08 + Conversion of token inside Cmd_t + CmdUnknown ErrorCode + Hexadecimal and decimal conversion
    [cmd_uart.h, kl_lib_L15x.h]
2014-05-13 * All data in pill int32 * Structure of Pill - Infinity + new types of pill + PillProg prints pill when inserted
2014-05-15 + RepeatedWrite, but without error correction
    [kl_lib_L15x.cpp]
2014-05-15 Device types switched to enum
2014-05-21 Switch to interactive dev type in progress * Fixed Damage=0 detector bug
    [main.cpp, radio_lvl1.cpp]
2014-05-24 + Pelengator functionality implemented and slightly tested + OnBlinkEnd functionality added to LED
2014-05-25 + Pill Cure/Damage + Tested Pill SetTop + Panacea
    [kl_lib_L15x.h, pill.h]
2015-05-30 Switch to newer libs
    [$ChibiArmlet.sch]
2015-05-31 CPU name changed
    [ChibiArmlet.sch]
2015-06-07 Release version * switched to 500kBit/s * Power lowered to -10dBm
2015-06-25 + MSI range setup + WS LED switches color correctly But sequensor still not implemented
    [$ChibiArmlet.sch]
2015-06-25 + WS2812 sequensor implemented + Switch delay moved to Color_t
2015-06-25 + Indication by LedWs implemented
2018-05-12 Some sch changes
    [ChibiArmlet.sch]
2018-05-20 + Led on if RSSI is high enough
2018-06-19 Switch to atollic
2019-04-14 Switch to newer OS etc.
2019-05-04 + Control of power and damage etc.
    [main.cpp, radio_lvl1.h]
2019-05-04 + Blink and Beep on demand * Switch to TIM9 as sys timer
